jwmelvin/airRoaster/state-plan.md

# state-plan — planned work and phase specifications

> Companion to [state-current.md](state-current.md) (what is active now) and
> [state-archive.md](state-archive.md) (what is done, and the review findings
> these phases answer). Findings are referenced as F-numbers from the archive.

## NEXT — remaining on-roaster validation

The live sessions of 2026-07-02/03/04 (see the archive's v0.12–v0.15 entries)
validated much of the original checklist; items are marked accordingly.
Remaining drills, roughly in commissioning order:

1. ~~**Boot sync sanity**~~ — **done/superseded.** Heat-zero at boot stands;
   fan-level adoption via `getLevel()` was replaced by the RTC no-init shadow
   (v0.15.0, reads lie while firing). Fan-through-reboot validated 2026-07-04
   via a live OTA update with the fan running.
2. **Sensor path**: BT read sane in live sessions, but the specific checks are
   unrecorded — `STAT` after a few minutes (`loopMaxUs` should be dominated by
   the ~30 ms display push, not sensor reads); compare RTD fault frequency in
   the log against pre-v0.8.0 roasts (emi.md addendum says what to expect).
3. **Failsafe drills** (roaster cold, heat low): engage `INLET`, unplug the
   inlet TC → expect `inlet failsafe: inlet PV stale` within ~3 s, heat 0,
   mode manual. Confirm a TUNE aborts the same way.
4. **Telemetry + dashboard** — **mostly done**: the commissioning sequence
   (TUNE → APPLY → FF cal → INLET) ran end-to-end in the 2026-07-03 session.
   Still unchecked: kill/restore WiFi to see auto-reconnect on both sides.
5. **WDT confidence**: none of the normal paths (tune, big display repaints,
   WS bursts) should approach 8 s — `loopMaxUs` gives the margin number.
6. ~~**DimmerLink reset escalation**~~ — **superseded.** v0.13.0 removed
   autonomous resets entirely (soft reset drives the output full-on for
   ~3–4 s); resets are operator-only via `DLRESET`. The fw-version line at
   boot is still worth a glance.
7. **Interlock config (v0.10.0)**: from the dashboard panel set soft mode and
   custom limits, confirm the heat cap follows the fan slider accordingly, then
   power-cycle and confirm the values and mode survive (NVS). Try an invalid
   set (`IL 0 55 30`) and confirm it is rejected.
8. ~~**Power linearization (v0.11.0)**~~ — **done.** TUNE and FF calibration
   were re-run post-map; closed loop settles on SV and FF compensates fan
   steps (validated 2026-07-03, v0.14.1).
9. **OTA idle gate (v0.12.0)**: an OTA push with heat > 0 should time out on
   the host, then succeed again at heat 0. The happy path (idle OTA push,
   reboot, fan preserved) is validated.
10. **Curve experiments** (`CURVE FAN 0|2`, optional): compare fan response per
    level step on the dashboard chart; expectation is RMS (1) remains best.
    Reboot restores RMS automatically.
11. **Cooldown guard (v0.16.0)** — *mostly validated 2026-07-05*: deferral,
    hold, auto-release, and soak-back re-enforcement all observed working on
    the roaster. The 30 s dwell released early into soak-back (two re-enforce
    cycles), so the dwell is now adjustable (`COOL DWELL <s>`, NVS): find the
    dwell that makes one release stick (start ~90–120 s) and set it. Still
    unchecked: `COOL MIN`/`COOL DWELL` surviving a power cycle (NVS), and
    `COOL OFF` releasing a held fan immediately.
12. **Ambient reporting (v0.17.0)** — on a cold roaster, power up and check the
    serial log for `ambient: cold-start capture` with a sane room temp (BT vs
    CJ within 8 °C); dashboard Ambient panel should show it. Then run the
    roaster hot, power-cycle, and confirm the log says `warm boot … keeping`
    and the stored capture is unchanged. Check `AMB SRC`/`AMB <degC>` survive
    a power cycle (NVS). In Artisan: map the `AT` node to an extra WebSocket
    channel, select it on Config › Device › Ambient, and confirm Roast
    Properties picks up the ambient temperature at CHARGE (README § Ambient
    temperature has the click-path).
13. **Command auth (v0.18.0)** — with `AUTH_KEY` in secrets.h: dashboard
    authenticates automatically (key field) and `AUTH` reports authed; set
    `AUTH MODE CONFIG` and confirm an *unkeyed* browser gets "AUTH required"
    for `PID`/`IL`/`COOL MIN` but can still run `OT1 60`, `OT1 0`, `INLET
    OFF`, `COOL ON`; set `AUTH MODE FULL` and confirm `OT1 60` is refused
    unkeyed while `OT1 0` still works; run `tools/roaster_proxy.py` with the
    key and confirm live Artisan drives sliders through it in FULL mode;
    wrong-key proxy → refused; mode survives a power cycle (NVS); serial
    stays fully trusted. Also confirm a keyless build (empty AUTH_KEY)
    behaves exactly as v0.17.

## Completed phases (specs kept for reference; details in the archive)

## Phase 1 — firmware safety (FW 0.7.0) — DONE 2026-07-02

*Answers F1 (boot level mismatch), F3 (closed-loop sensor failsafe), F6
(unchecked dimmer writes), F8 (no watchdog).*

1. **Boot dimmer sync.** After `initDL()` for both modules: force heat to 0
   (`setLevel(HEAT_ADDR, 0)`, retried); read the fan's actual level with
   `getLevel(FAN_ADDR)` and adopt it into `fanLevel` — after a crash mid-roast
   the fan keeps cooling the hot roaster while the heat is killed. Log if the
   sync fails.
2. **Inlet-loop failsafe.** Track inlet-PV freshness (`inLastGoodMs` stamped in
   `updateSensors()` on every accepted MAX31855 read). In `MODE_INLET`:
   - PV stale (> `INLET_PV_STALE_MS`, 3000 ms) → drop to `MODE_MANUAL`,
     heat 0, `logError`, broadcast. A frozen hold-last-good PV must never keep
     feeding the integrator.
   - Over-temp (`inTemp > INLET_OVERTEMP_C`, reuse 280 °C) → same action.
   - `MODE_TUNE` gains the same stale-PV abort (it already has over-temp).
3. **Checked dimmer writes.** `applyInterlock()` and the OT2 path only update
   the cached level when `setLevel()` returns true; on failure the cache keeps
   the old value so the next loop retries, with a rate-limited log entry. Add a
   **readback audit** to the existing 5 s DimmerLink error poll: `getLevel()`
   both channels; mismatch against the cached value → log + rewrite.
4. **Task watchdog.** `esp_task_wdt` (IDF 5 API: `esp_task_wdt_reconfigure` /
   `_init` with `esp_task_wdt_config_t`, `trigger_panic = true`, ~8 s), add the
   loop task, `esp_task_wdt_reset()` each loop; feed it inside the WiFi connect
   wait until Phase 3 makes that non-blocking. Safe only because of item 1.

## Phase 2 — MAX31865 direct-register driver (FW 0.8.0) — DONE 2026-07-02

*Answers F2 (blocking one-shot reads / defeated continuous-mode design) and
F10 (blind jitter metric). Datasheet traceability in state-archive.md.*

1. New local header `max31865_direct.h`, small class, no external deps:
   - Own SPI transactions: `SPISettings(1_000_000, MSBFIRST, SPI_MODE1)`,
     manual CS. Registers: read `0x0N`, write `0x8N`, MSB first, auto-increment
     multibyte.
   - `begin()`: config = `VBIAS(0x80) | AUTO(0x40)` (+3-wire/50 Hz bits if ever
     needed; we run 4-wire, 60 Hz ⇒ 0xC0), thresholds armed (below), faults
     cleared. Filter bit set before enabling auto mode (datasheet forbids
     changing the notch while converting).
   - `reassert()`: rewrite the config byte — this makes the existing
     `RTD_REASSERT_MS` stall guard actually meaningful.
   - `readRaw(bool &fault)`: one 2-byte read at 0x01; bit 0 of the pair is the
     per-sample fault flag; value is the 15-bit ratio.
   - `readFault()` / `clearFault()`: plain register read of 07h (no
     master-initiated fault cycle — the Adafruit default knocks the chip out of
     auto mode); clear via config D1 with D5/D3/D2 zero.
   - Temperature from raw via Callendar–Van Dusen (same math as the Adafruit
     `calculateTemperature`, implemented locally).
   - Threshold arming: convert `RTD_VALID_MIN_C`/`RTD_VALID_MAX_C` to raw via
     forward CVD `R = R0(1 + AT + BT²)` (B-term adequacy at −20 °C is fine for
     a fault threshold), write as 15-bit << 1. The chip then latches D7/D6 on
     every out-of-window conversion — on-silicon EMI evidence.
2. Rework `serviceRtd()` to use the driver: the two-read disagree check
   becomes two cheap register reads (a true SPI-glitch detector), fault
   evidence is no longer destroyed by the read path, and per-sample fault bits
   feed the debounce. Median filter, debounce, hold-last-good, rate-limited
   logging all stay as-is.
3. Remove the `Adafruit_MAX31865` dependency (keep MAX31855 — verified
   non-blocking and correct).
4. **Honest load metric**: track worst single `loop()` duration (µs) alongside
   the control-jitter watch; report and reset both via `STAT`
   (`loopMaxUs` field). The old metric couldn't see in-pass blocking.

## Phase 3 — protocol hardening + telemetry (FW 0.9.0) — DONE 2026-07-02

*Answers F4 (garbage parses as zero), F5 (JSON envelope int-rounds the ramped
setpoint), F7 (WiFi), F9 (DimmerLink extras), tune-settled flag, and adds the
telemetry channel the dashboard needs.*

1. **Strict numeric parsing** (`parseFloatStrict`/`parseIntStrict`): `OT1 x`
   or `PID a b c` is rejected with a reply to the sender, never treated as 0,
   and never persisted to NVS.
2. **JSON envelope keeps floats**: `{"command":"INLET","value":183.4}` becomes
   `INLET 183.40` (currently rounded to int — quantizes Artisan's ramped
   playback to 1 °C steps).
3. **WiFi**: bounded connect wait (~15 s, WDT-fed, display progress), then boot
   proceeds regardless; `setAutoReconnect(true)` plus a rate-limited reconnect
   check in loop; display already shows state. Roaster must be fully usable
   over serial with no WiFi.
4. **TUNE result gains `"settled":true|false`** — a timeout fit underestimates
   dT and suggests too-hot gains; the flag says whether to trust it.
5. **DimmerLink extras**: log VERSION (reg 0x03) at init; escalate to COMMAND
   RESET (reg 0x01 ← 0x01) after N consecutive error-poll failures, then
   re-init (re-assert curve, restore level). Level readback audit came in
   Phase 1.
6. **`FF AMB` with no value** seeds `ffAmbient` from the MAX31855 cold-junction
   temperature (`readInternal()`), with the enclosure-warmer-than-room caveat
   documented.
7. **Telemetry push**: every `TELEM_PERIOD_MS` (default 1000 ms; 500 ms during
   TUNE) broadcast
   `{"pushMessage":"telem","data":{"t":<ms>,"IN":..,"BT":..,"ET":..,"sv":..,"heat":..,"heatReq":..,"fan":..,"ilCap":..,"mode":"..","p":..,"i":..,"d":..,"ff":..,"fltIN":0|1,"fltBT":0|1}}`
   — the PID terms come from the last `controlStep()`. `TELEM <ms>|OFF` command
   (clamped 100–10000). Skip building the string when no client is connected.

## Phase 4 — dashboard rebuild — DONE 2026-07-02

Single file, zero dependencies, works from `file://`. Grouped panels:

1. **Connection** — IP (remembered), connect/disconnect, auto-reconnect with
   backoff, status dot.
2. **Status** — mode badge (manual/inlet/tune), heat bar showing applied vs
   requested, fan bar, interlock state/cap, inlet SV.
3. **Temperatures** — large IN/BT/ET readouts, per-channel fault badges from
   telemetry flags.
4. **Inlet tuning** (the centerpiece) —
   - Canvas strip chart: IN (PV) and SV on the temperature axis, heat on a
     0–100 % axis; rolling buffer (≥30 min at 1 Hz), pause, window selector,
     CSV export of the buffer.
   - PID editor prefilled from `pid` pushes; FF editor (`ffK`, ambient, CAL,
     OFF); live P/I/D/FF term readout.
   - TUNE workflow: start (step % field), abort; on result show the model
     (Kp/tau/theta/dT, settled flag) and both gain sets with **Apply tight**
     and **Apply cons** buttons (cons applies via `PID <kp> <ki> 0`).
5. **Console + log** — every message timestamped into a capped capture buffer;
   per-class filter checkboxes (status/telem/error/log/tune-pid-ff-stat/sent/
   other; telem hidden by default), free-text filter, **Save log** (.txt
   download) — the device log is 8 RAM entries, so the browser is the real
   archive; `LOG` requested on connect.
6. **Commissioning** — existing sequence panel, retained and updated.

## Phase 5 — docs sync — DONE 2026-07-02

- README: interlock constants (code says 48/55/30, README says 23/30/30),
  dashboard path (repo root, not `artisan/`), delete the stale "BT/ET stubbed
  at 0.0" paragraph, document new commands (`TELEM`, no-arg `FF AMB`), boot
  dimmer sync, watchdog, WiFi behavior, `settled` flag, direct-driver sensor
  path.
- emi.md addendum: the library one-shot discovery — unbiased auto-convert
  windows between polls were a plausible contributor to spurious `0x60`
  faults; continuous mode changes the experiment. Note what to watch in the
  next roast's fault log.
- Keep state docs current per the update discipline in state-current.md.

## Later / not scheduled

- **Evaluate moving the DimmerLink link from I2C back to UART serial.** The
  modules ship UART-by-default and were switched to I2C during provisioning
  (see [config.md](config.md) § 3); on this project's questionable wiring the
  serial link has looked *at least as noise-tolerant* as I2C. Worth a
  controlled comparison — if serial holds up, it may be the more robust
  transport here. Would touch the DimmerLink transport layer in
  `airRoaster.ino` (register reads/writes, `initDL`/`assertDLState`,
  boot sync) but not the control law; keep the commit-on-ack + re-assert
  robustness shape (v0.13). Cross-reference the EMI history in
  [hardware/emi.md](hardware/emi.md).
- **Auto-provision a fresh DimmerLink module in place (UART→I2C on the I2C
  pins).** A factory module ships on UART at the default I2C address `0x50`
  ([config.md](config.md) § 3); today that switch is a separate bench sketch.
  Idea: do it in-firmware without rewiring by temporarily driving the I2C pins
  (SDA `GPIO3` / SCL `GPIO4`) as a UART through the ESP32-S3 GPIO matrix. Flow:
  on boot (or a `DLPROVISION HEAT|FAN` command), if the expected address does
  not ACK, tear down `Wire`, bring a UART peripheral up on those pins, send
  `SWITCH_I2C` (`0x5B`), wait for the mode to persist, tear the UART down,
  `Wire.begin()`, write the target address to reg `0x30`, verify `VERSION`.
  Open questions to resolve first: (a) confirm the module's UART TX/RX land on
  the *same* two physical pins as its I2C SDA/SCL (the "two-bus" connector) —
  this is the crux; (b) confirm the DimmerLink UART baud/framing from the UART
  protocol docs; (c) collision — two fresh modules both answer `0x50`, so this
  only works with a single unaddressed module on the bus (provision one at a
  time, or before the second is wired); (d) safety — only with heat off and the
  boot heat-zero intact. Payoff: plug in a replacement dimmer and it
  self-provisions.
- **Data-driven device registry (add a device via a `.json` change) — all
  buses.** Make adding an *auxiliary* peripheral a config edit, not a code
  edit: a small JSON manifest of `{bus, addressing, type, role, options}` the
  firmware reads at boot to instantiate/parse the device. The idea is not
  I2C-specific — it applies the same way across **all three buses**, with the
  bus deciding the addressing field: I2C → device address, SPI → chip-select
  pin (+ SPI mode/clock), serial/UART → port + baud/framing. Candidate
  storage: a compiled-in JSON string, an NVS blob, or a LittleFS/SPIFFS file
  flashed with the firmware (or pushed from the dashboard). Scope guard: keep
  the **safety-critical core** devices (both dimmers, inlet TC, the RTDs)
  hardcoded and interlocked — the registry is for optional sensors first (the
  BME688 ambient below, an extra RTD, environmental sensors) whose presence and
  wiring vary. A full driver-plugin system is a large refactor; a lighter first
  cut is a table of *known* optional device types keyed by bus+address. Ties
  into the dimmer auto-provision above (address assignment) and the BME688 item
  below.
- **Cryptographic authentication of the command interface (safety/security).**
  **→ PROMOTED 2026-07-10: in development as v0.18.0 on `feature/auth-proxy`**
  (see state-current.md). The notes below are the original design record.
  Today the WebSocket server on `:81` accepts plaintext commands from anyone on
  the network — `OT1`/`OT2`/`INLET`, and the safety config (`IL`, `COOL`,
  `DLRESET`, `PID`, `FF`, `CURVE`, `AMB`). On a private WLAN the risk is low,
  but this drives a **heating element**, so an unauthenticated write path is the
  standing exposure. Goal: only authorized clients can issue state-changing
  commands. **The hard constraint is Artisan**: its WebSocket client speaks
  plain `ws://` with no auth header, token, or `wss` client-cert support, so
  mandatory auth would break the primary use. Design has to be layered:
  - Keep the *read* path (`getData`, telemetry, `LOG`, `STAT`) and the Artisan
    *slider* commands usable, and authenticate the privileged/mutating commands
    — or gate privileged commands to the dashboard only while Artisan keeps a
    reduced, network-trust-scoped surface.
  - Candidate mechanisms, lightest first: **HMAC-signed command envelope**
    (shared key + monotonic nonce/timestamp for replay protection) — cheap, no
    TLS handshake, fits the existing JSON envelope; **challenge–response
    session auth** on connect (device issues a nonce, client proves the shared
    key, session trusted thereafter); or full **`wss`/TLS** via mbedTLS (heavier
    on RAM/latency, and still doesn't solve Artisan). OTA already carries a
    shared password (`OTA_PASS`) — precedent for a secret in `secrets.h` + NVS.
  - Dashboard gotcha to verify early: the browser HMAC needs Web Crypto
    (`crypto.subtle`), which requires a **secure context** — `file://` and
    `localhost` qualify, but a dashboard served over `http://<lan-ip>` may not,
    which would block signing. Confirm before committing to a browser-HMAC
    design.
  - **Parked (2026-07-10, operator decision):** mandatory auth stays off the
    table for now because Artisan must keep sending commands or the setup
    doesn't work. The workable shape, if/when revisited, is a **localhost
    signing proxy**: Artisan connects to `ws://127.0.0.1:<port>` on the
    operator's machine (unauthenticated but localhost-bound), and the proxy
    holds the shared key and signs traffic to the roaster, which rejects
    unsigned writes. Artisan needs no changes beyond the Host field. The
    "laptop becomes the sole operator" concern is softer than it sounds:
    *keyed devices* are operators (any machine with the key can run the proxy;
    the dashboard could HMAC directly), and the Artisan machine is already the
    operator console — the proxy co-locates with it. What's lost is ad-hoc
    access from unkeyed devices; the fix is an unauthenticated **safe subset**
    in firmware — reads plus safety-increasing commands only (`OT1 0`,
    `INLET OFF`, `COOL ON`) — so anything on the network can still stop the
    roaster, never start it. **Operator-approved (2026-07-10): the safe subset
    is a requirement of any future auth design**, not an optional mitigation.
    A proxy crash mid-roast is no worse than
    Artisan crashing: the firmware failsafes are client-independent.
  - Open questions: which exact commands are "privileged" vs open; replay/nonce
    persistence across reboot; key provisioning + rotation; and whether to pair
    this with network-level isolation (roaster VLAN) as the pragmatic near-term
    mitigation while the crypto path is built.
- **OTA hardening beyond the dedicated password** (first-order fix shipped
  2026-07-11: `auth_key.py ota` generates a random `OTA_PASS`, closing the
  WIFI_PASS fallback where anyone on the WLAN could push firmware). Two
  further layers, deliberately deferred: (a) **OTA arming** — only call
  `ArduinoOTA.handle()` for ~5 min after an authenticated `OTA ARM` command
  (TIER_CONF or serial), so a push needs both secrets and accidental pushes
  are impossible; cheap (a flag + timeout + one command) and consistent with
  the existing idle gate — do this one first if OTA exposure ever worries us
  again. (b) **Signed images / ESP32 Secure Boot** — defends adversaries who
  already hold the passwords; Secure Boot burns irreversible eFuses and the
  ESP32 Arduino core lacks built-in update signing (unlike ESP8266), so this
  is real toolchain work for a threat beyond the stated LAN model. espota
  transport remains cleartext either way — key-bearing flashes stay on USB.
- ET RTD probe installation → set `RTD_ET_ENABLED 1` (sensor code is ready).
- BME688 ambient sensor on STEMMA QT (`0x76/0x77`) — would give a true room
  ambient for feedforward instead of the cold-junction estimate.
- DimmerLink curve-mode experiments: curve is set to RMS (mode 1) at
  startup; LINEAR/LOG untested.
- Move `controlStep()` to a pinned FreeRTOS task if `STAT` evidence (post
  Phase 2, when the metric is honest) ever shows the cooperative loop failing
  its cadence.
- String→char parsing in hot paths if heap fragmentation ever shows (low
  priority on the S3 with PSRAM).
