jwmelvin/airRoaster/artisan/artisan_help_events.md

# Artisan Event Configuration Help

Copied from Artisan's help dialogs for the Event configuration (Buttons and Sliders tabs), reformatted for readability.

## Event Custom Buttons

Button numbers can be drag-and-dropped to a new position. While holding ALT (Windows) / OPTION (macOS), buttons are swapped instead.

### Button table columns

| Column | Description |
|---|---|
| Button Label | Enter `\n` to create labels with multiple lines. `\t` is substituted by the event type. |
| Event Description | Description of the event to be recorded. |
| Event Type | Event type to be recorded, or leave blank for no event. `±` types add a chosen offset (positive or negative) to the present value of the chosen event. |
| Event Value | Value of the event (1–100) to be recorded. |
| Action | Perform an action at the time of the event. |
| Documentation | The action command. Depends on the action type; `{}` is replaced by the event value (plus the offset for `±` event types). |
| Button Visibility | Hides/shows the individual button. |

### Configuration options

| Option | Description |
|---|---|
| Max buttons per row | Sets a maximum number of buttons to display on a single row. |
| Button size | Sets a size for the buttons: tiny, small, or large. |
| Color Pattern | Applies one of 99 autogenerated color patterns to the buttons. Set to `0` to choose button colors manually. |
| Mark Last Pressed | Inverts state and color of the last button pressed. |
| Tooltips | Shows the button specification as a tooltip when hovering over a button. |
| Add | Adds a new button to the bottom of the table. |
| Insert | Inserts a new button above the selected button. |
| Delete | Deletes the selected button. |
| Copy Table | Copies the button table in tab-separated format to the clipboard. Option/ALT-click to copy a tabular format instead. |
| Help | Opens this window. |

### Label substitutions

The following substitutions are applied to button labels:

| String | Substitution |
|---|---|
| `\n` | New line character |
| `\t` | Event name (translated if using default event names) |
| `\q` | Event type 1 |
| `\w` | Event type 2 |
| `\e` | Event type 3 |
| `\r` | Event type 4 |
| `\0` | OFF (translated) |
| `\1` | ON (translated) |
| `\2` | OFF (translated, respecting button state) |
| `\3` | ON (translated, respecting button state) |
| `\p` | STOP (translated) |
| `\s` | START (translated) |
| `\P` | STOP (translated, respecting button state) |
| `\S` | START (translated, respecting button state) |
| `\c` | CLOSE (translated) |
| `\o` | OPEN (translated) |
| `\C` | CLOSE (translated, respecting button state) |
| `\O` | OPEN (translated, respecting button state) |
| `\a` | AUTO (translated) |
| `\m` | MANUAL (translated) |
| `\A` | AUTO (translated, respecting button state) |
| `\M` | MANUAL (translated, respecting button state) |
| `\i` | STIRRER |
| `\f` | FILL |
| `\D` | DISCHARGE |
| `\R` | RELEASE |
| `\h` | HEATING |
| `\l` | COOLING |
| `\b` | FLAP |
| `\d` | CONTROL |
| `\V` | Event value |
| `\F` | Event value interpreted as temperature in Fahrenheit, converted to the current temperature mode |
| `\T` | Event value interpreted as temperature in Celsius, converted to the current temperature mode |

### Button commands

Notes:

- `{}` can be used as a placeholder; it is substituted by the current button value plus the offset for `±` event types. If the placeholder occurs several times in a description/command, all occurrences are replaced by the value.
- The placeholders `{ET}`, `{BT}`, `{time}`, `{ETB}`, `{BTB}`, and `{WEIGHTin}` are substituted by the current ET, BT, time, ET background, BT background value, and batch size (in g) in Serial/Artisan/CallProgram/MODBUS/S7/WebSocket commands.
- Commands can be sequenced, separated by semicolons: `<cmd1>;<cmd2>;<cmd3>`.
- All characters given as documentation to a **Serial Command** action are sent as one string to the connected device. If the device can interpret this string as separate commands separated by semicolons, this is fine. Otherwise, use a **Multiple Event** referencing several event buttons (via a comma-separated list of event button numbers as the documentation string), where each referenced button issues one command via its own Serial Command action. Those buttons can be hidden, giving the same effect as if the Serial Command allowed a sequence of commands.
- In PHIDGET commands, the optional parameter `<sn>` has the form `<hub_serial>[:<hub_port>]` and refers to a specific Phidget HUB by its serial number, optionally specifying the port the addressed module is connected to.

#### Simple actions

| Action | Command | Description |
|---|---|---|
| Serial Command | ASCII serial command or binary `a2b_uu(serial command)` | |
| Call Program | A program/script path (absolute or relative) | Starts an external program |
| Multiple Event | Button numbers or `sleep(<float>)` separated by commas: `1,2,sleep(2.5),3` | Triggers other buttons |
| p-i-d | `<p>;<i>;<d>` | Configures PID to the values `<p>;<i>;<d>` |
| Fuji Command | `write(<unitId>,<register>,<value>)` | |

#### Artisan Command

| Command | Description |
|---|---|
| `$` | Variable holding the last state of the button pressed (1 or 0) |
| `alarm(n,<bool>)` | Enables/disables alarm number `n` |
| `alarms(<bool>)` | Enables/disables alarms |
| `autoCHARGE(<bool>)` | Enables/disables autoCHARGE |
| `autoDROP(<bool>)` | Enables/disables autoDROP |
| `sleep(<float>)` | Adds a delay of `<float>` seconds |
| `tare(<int>)` | Tares channel `<int>` with 1: ET, 2: BT, 3: E1c1, 4: E1c2, … |
| `PIDon` | Turns PID on |
| `PIDoff` | Turns PID off |
| `PIDtoggle` | Toggles the PID state |
| `pidmode(<int>)` | Sets PID mode to 0: manual, 1: RS, 2: background follow |
| `p-i-d(<p>,<i>,<d>)` | Sets the p-i-d parameters of the PID |
| `pidWeights(<beta>,<gamma>)` | Sets the beta and gamma parameters of the PID |
| `adjustSV(<float>)` | Increases or decreases the current target SV value by `<float>` |
| `pidSV(<float>)` | Sets the PID target set value SV |
| `pidSVC(<float>)` | Sets the PID target set value SV, given in °C |
| `pidRS(<rs>)` | Activates the PID Ramp-Soak pattern number `<rs>` (1-based!) or the one labeled `<rs>` |
| `pidSource(<int>)` | Selects the PID input source: 0: BT, 1: ET (Software PID); 0–3 (Arduino PID) |
| `pidLookahead(<int>)` | Sets the PID lookahead in seconds |
| `replayLookahead(<int>)` | Sets the Ramping Event Replay lookahead in seconds |
| `popup(<msg>[,<int>])` | Shows a popup with message `<msg>`, optionally auto-closing after `<int>` seconds |
| `message(<msg>)` | Shows message `<msg>` in the message line |
| `notifications(<bool>)` | Enables/disables notifications; while disabled, issued notifications are ignored |
| `notify(<title>[,<msg>])` | Sends a notification with title `<title>` and optional message `<msg>` |
| `setCanvasColor(<color>)` | Sets canvas color to the RGB-hex `<color>`, e.g. `#27f1d3` |
| `resetCanvasColor` | Resets canvas color |
| `button(i,b)` | Sets button `i` to pressed if `b` is yes/true/t/1, otherwise to normal |
| `button(<name>\|<bool>)` | Activates button `<name>` from { START, CHARGE, DRY, FCs, FCe, SCs, SCe, DROP, COOL, OFF }; sets the calling button to "pressed" if the argument is 1 or True |
| `button()` | Toggles the state of the button |
| `visible(i,b)` | Sets button `i` to visible if `b` is yes/true/t/1, otherwise to hidden |
| `palette(<p>)` | Activates palette `<p>`, either a number 0–9 or a palette label |
| `playbackmode(<int>)` | Sets playback mode to 0: off, 1: time, 2: BT, 3: ET, 4: BT/time, 5: ET/time |
| `playbackdropmode(<int>)` | Sets playback DROP mode to 0: off, 1: time, 2: BT, 3: ET |
| `playback(n,<bool>)` | Toggles playback per event type `n` from {1,2,3,4} |
| `ramp(n,<bool>)` | Toggles playback ramping per event type `n` from {1,2,3,4} |
| `slider(n,<bool>)` | Shows/hides the slider per event type `n` from {1,2,3,4}; `n=5` toggles the PID SV slider visibility |
| `quantifier(n,<bool>)` | Activates/deactivates quantification per event type `n` from {1,2,3,4} |
| `setBatchSize(<float>)` | Sets the batch size to the given value. If the value is negative, the batch size is taken from the background profile, if one is loaded |
| `openProperties` | Opens the Roast Properties dialog |
| `loadBackground(<filepath>)` | Loads the `.alog` profile at the given filepath as background profile |
| `clearBackground` | Clears the current background profile |
| `alarmset(<as>)` | Activates the alarmset with the given number or label |
| `moveBackground(<direction>,<int>)` | Moves the background profile the indicated number of steps in `<direction>`: up, down, left, or right |
| `keyboard(<bool>)` | Enables/disables keyboard mode |
| `keepON(<bool>)` | Enables/disables the Keep ON flag |
| `showCurve(<name>,<bool>)` | Shows/hides the curve indicated by `<name>`, one of { ET, BT, DeltaET, DeltaBT, BackgroundET, BackgroundBT } |
| `showExtraCurve(<extra_device>,<curve>,<bool>)` | Shows/hides the `<curve>` (one of {T1, T2}) of the zero-based `<extra_device>` number |
| `showEvents(<event_type>,<bool>)` | Shows/hides the events of `<event_type>` in [1..5] |
| `showBackgroundEvents(<bool>)` | Shows/hides the events of the background profile |

#### WebSocket Command

| Command | Description |
|---|---|
| `$` | Variable holding the last state of the button pressed (1 or 0) |
| `send(<json>)` | If `{}` substitutions are used, JSON brackets need to be duplicated to escape them, as in `send({{ "value": {}}})` |
| `sleep(<float>)` | Adds a delay of `<float>` seconds |
| `button(i,b)` | Sets button `i` to pressed if `b` is yes/true/t/1, otherwise to normal |
| `button(<bool>)` | Sets the calling button to "pressed" if the argument evaluates to 1 or True |
| `button()` | Toggles the state of the button |
| `read(<json>)` | If the `<json>` text respects the JSON format, it is sent to the connected WebSocket server and the response is bound to the variable `_` |

## Event Custom Sliders

### Slider table columns

| Column | Description |
|---|---|
| Event | Hide or show the corresponding slider. |
| Action | Perform an action on slider release. |
| Command | Command to perform, depends on the Action type. `{}` is replaced by (slider value × Factor + Offset). |
| Offset | Offset added to the slider value (after scaling by Factor). |
| Factor | Scale factor; the slider value is multiplied by this value. |
| Min | Sets the minimum value of the slider range. |
| Max | Sets the maximum value of the slider range. |
| Course | When ticked, the slider moves in steps of 10. |
| Temp | Should be ticked when the slider's value is a temperature, so Artisan can properly scale the value between Celsius and Fahrenheit. |
| Unit | Optional text used in annotations for the units of the slider value. |

### Slider commands

Notes:

- `{}` can be used as a placeholder; it is substituted by (value × factor + offset). In all slider command actions except IO, VOUT, S7, and RC Commands, the bound value is converted from float to int.
- The placeholders `{ET}`, `{BT}`, `{time}`, `{ETB}`, `{BTB}`, and `{WEIGHTin}` are substituted by the current ET, BT, time, ET background, BT background value, and batch size (in g) in Serial/Artisan/CallProgram/MODBUS/S7/WebSocket commands.
- Commands can be sequenced, separated by semicolons: `<cmd1>;<cmd2>;<cmd3>`.
- In PHIDGET commands, the optional parameter `<sn>` has the form `<hub_serial>[:<hub_port>]` and refers to a specific Phidget HUB by its serial number, optionally specifying the port the addressed module is connected to.
- In YOCTOPUCE commands, the optional parameter `<sn>` holds either the module's serial number or its name.

#### Simple actions

| Action | Command | Description |
|---|---|---|
| Serial Command | ASCII serial command or binary `a2b_uu(serial command)` | |
| Call Program | A program/script path (absolute or relative) | Starts an external program |
| Fuji Command | `write(<unitId>,<register>,<value>)` or `sleep(<float>)` | |

#### Artisan Command

Sliders support the same Artisan commands as buttons (see [Artisan Command](#artisan-command) above), with these differences:

- No `$` variable.
- No `alarms(<bool>)`, `button(i,b)`, `button()`, or `visible(i,b)`.
- `button(<name>)` takes only a name from { START, CHARGE, DRY, FCs, FCe, SCs, SCe, DROP, COOL, OFF } — no `<bool>` form.

#### WebSocket Command

| Command | Description |
|---|---|
| `send(<json>)` | If `{}` substitutions are used, JSON brackets need to be duplicated to escape them, as in `send({{ "value": {}}})` |
| `sleep(<float>)` | Adds a delay of `<float>` seconds |
| `button(<bool>)` | Sets the calling button to "pressed" if the argument evaluates to 1 or True |
| `read(<json>)` | If the `<json>` text respects the JSON format, it is sent to the connected WebSocket server and the response is bound to the variable `_` |
