jwmelvin/airRoaster/(commit log)

2026-06-07 Send error log to Serial when LOG command received over serial
    [airRoaster_v01.ino]
2026-06-08 Add Artisan WebSocket protocol support
    Handle Artisan's getData request/response cycle with matching id field.
    Stub BT/ET temperature floats ready for real sensor integration.
    Plain-text OT1/OT2 commands remain for direct and slider control.
2026-06-08 Wrap all push messages in Artisan pushMessage envelope
    Status, error, and log broadcasts now use {"pushMessage":"<type>","data":...}
    for a consistent format across Artisan and other WebSocket clients.
    [airRoaster_v01.ino]
2026-06-08 Document sensor expansion path in README
    Explains how to add channels to the main WebSocket device and how
    to configure extra Artisan devices for additional sensors.
2026-06-08 Fix sensor expansion docs: clarify 10-channel limit and extra device path
    All extra devices point at the same WebSocket endpoint; a second port
    is only needed beyond 10 total channels.
2026-06-22 Add soft interlock mode, IL toggle command, and Artisan config context
    Replaces the single FAN_INTERLOCK_THRESHOLD with a two-mode interlock:
    hard (binary cutoff at IL_FAN_MIN) and soft (linear ramp from IL_FAN_MIN
    to IL_FAN_FULL). The IL command toggles between modes. Status broadcast
    now reports ilCap and ilSoft instead of the old interlock bool.
    DimmerLink init moved before WiFi to avoid missing the ready window.
    Adds artisan_config_context.md documenting the full Artisan setup.
    [airRoaster_v01.ino]
2026-06-28 Add sensor reading, Artisan IN channel, and display temp readout
    Initializes MAX31865 (BT, ET) and MAX31855 (IN) sensors with continuous
    conversion; polls every 250 ms. Adds IN to the Artisan getData response
    and displays all three temps on the bottom OLED row.
2026-06-29 Add closed-loop inlet temperature control (v0.3.0)
    Internalize inlet-temp regulation so heat is modulated on-device instead of
    via Artisan's 1 Hz command cycle. New switchable MODE_INLET runs a PI(D) loop
    in controlStep(), with manual OT1 control as an instant override.
    Control law:
    - Derivative-on-measurement (no setpoint kick), low-pass filtered; starts
    PI-only (Kd=0) since the inlet TC is noisy near the dimmers.
    - Back-calculation anti-windup against the *applied* (post-interlock) heat, so
    the fan interlock capping heat can't wind up the integrator.
    - Bumpless engage; repeated INLET calls retarget without resetting the
    integrator (gradual setpoint changes during a roast don't reset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
    [airRoaster_v01.ino]
2026-06-29 Add feedforward airflow compensation (v0.5.0)
    Robustness against airflow changes — the primary design driver. Adds a
    physics-form feedforward summed into the control output:
    heat_ff = ffK * fan * (SV - ambient)
    Steady-state heater power scales with airflow times temperature rise, so a fan
    change moves heat immediately in proportion and the PID only trims the residual,
    instead of waiting for the inlet temperature to drift and the integrator to
    catch up. One coefficient covers the narrow fan band.
    - FF command: report / set ffK / FF AMB <degC> / FF CAL / FF OFF.
    - FF CAL auto-calibrates ffK = heat / (fan * (inlet - ambient)) from the current
    steady operating point.
    - Off by default (f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
    [airRoaster_v01.ino]
2026-06-30 Persist tuning set in NVS; fix OLED temp refresh (v0.6.0)
    Persistence: store PID gains (kp/ki/kd) and feedforward params (ffK,
    ffAmbient) in NVS flash via the Preferences library, namespace "tuning".
    loadTuning() at boot restores stored values over the compile-time
    placeholders (a virgin device keeps the defaults); saveTuning() is called
    only from the PID, TUNE APPLY, and FF mutation paths — never the control
    loop — so flash wear is negligible.
    Display: the OLED only repainted on command/tune events, so the temperature
    readout went stale between commands. Add a 1 Hz repaint heartbeat decoupled
    from the 250 ms sensor poll, keeping the full-framebuffer I2C push (a ~30 ms
    cooperative-loop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
    [airRoaster.ino]
2026-06-30 Add Artisan settings for firmware-side inlet control
    airRoaster_inlet.aset is a variant of airRoaster.aset configured for the
    internalized control loop (firmware MODE_INLET): Artisan sends the inlet
    setpoint rather than running its own PID. Adds a 0-300 °C "Inlet" SV slider
    and Inlet OFF / 190 / 220 buttons that emit INLET commands over WebSocket
    (send({"command":"INLET","value":...})). Fan/heat sliders unchanged; the
    original profile is left intact.
2026-07-02 Add ramped-playback events mode to inlet background generator
    make_inlet_background.py --events N emits N discrete T_inlet (event
    type 3) special events sampled off the shaped curve. Artisan's
    background-event playback (replay "by time") linearly interpolates the
    slider between them and fires send({"command":"INLET","value":{}}) each
    tick, streaming interpolated INLET setpoints to the firmware's
    closed-loop control.
    Points are progressively concentrated over the final portion of the
    roast (--tail-width / --tail-bias) for finest setpoint resolution
    through the development phase and the drop. Event value encoding, type,
    annotation strings, and charge alignment verified against Artisan
    source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
2026-07-02 README: link DimmerLink I2C protocol doc in the hardware table
    Add the dimmerlink-I2CCommunication reference next to the DimmerLink
    overview link, alongside the I2C addresses and curve-mode details it
    documents.
2026-07-02 Add state documents: current effort, phase plan, review-findings archive
    Development framework for picking up the project fresh: build workflow,
    ground-truth docs, conventions, safety posture, and the July 2026 review
    findings (F1-F12) with datasheet verification that grounds phases 1-5.
2026-07-02 Phase 1 safety: boot dimmer sync, inlet failsafe, commit-on-ack writes, WDT (v0.7.0)
    - Boot: heat forced to 0, fan's actual level adopted via getLevel, so an
    MCU-only reset can't leave the heater running against zeroed state (F1)
    - MODE_INLET drops to manual at heat 0 on stale PV (>3s) or over-temp
    (280C); TUNE gains the stale-PV abort (F3)
    - Dimmer level caches update only on acked I2C writes, failures retry
    every loop with rate-limited logging; 5s readback audit re-asserts
    level+curve on drift (F6)
    - esp_task_wdt (8s, panic->reset) on the loop task, fed during the WiFi
    connect wait (F8)
    [airRoaster.ino]
2026-07-02 Phase 2: direct-register MAX31865 driver, true continuous mode (v0.8.0)
    Replaces the Adafruit MAX31865 read path (F2): its temperature() is a
    blocking one-shot (~75ms delay per read) that toggles VBIAS off and
    clears the fault register on entry — stalling the loop ~150ms per 250ms
    cycle and defeating serviceRtd()'s continuous-mode design. New
    max31865_direct.h (register access per hardware/max31865.pdf pp.13-18):
    - chip held in auto-convert (VBIAS|AUTO, 60Hz notch); reads are
    microsecond register accesses
    - atomic RTD MSB+LSB read; per-sample fault bit feeds the robust layer
    - on-chip fault thresholds armed to the plausibility window
    - config re-assert makes the RTD_REASSERT stall guard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
    [airRoaster.ino, max31865_direct.h]
2026-07-02 Phase 3: strict parsing, float envelope, WiFi resilience, DL recovery, telemetry (v0.9.0)
    - Strict numeric parsing with error replies: garbage no longer coerces
    to 0 (OT1/OT2/INLET/PID/TUNE/FF); a typo can't persist zero gains (F4)
    - JSON command envelope preserves the fractional value so Artisan's
    ramped INLET playback isn't quantized to 1C steps (F5)
    - WiFi: bounded 15s connect, boots without network, loop-side link
    watch with reconnect kick (F7)
    - TUNE results carry "settled" — timeout fits suggest too-hot gains
    - DimmerLink: fw version logged at init, per-address rate-limited error
    logging, persistent-error streak escalates to module soft reset with
    curve/level re-assert (F9)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
    [airRoaster.ino]
2026-07-02 Phase 4: dashboard rebuild — grouped panels, tuning chart, durable log capture
    Single-file, zero-dependency rewrite around the v0.9.0 telemetry feed:
    - Connection: remembered IP, auto-reconnect with backoff, safety
    shortcuts (HEAT 0 / INLET OFF / TUNE ABORT) always visible
    - Status: mode badge, applied-vs-requested heat bar, fan bar, interlock
    - Temperatures: IN/BT/ET readouts with per-channel fault badges and a
    telemetry-freshness indicator
    - Inlet control: canvas strip chart (IN/SV/BT on temp axis, heat/fan on
    % axis, 5-60 min windows, pause, CSV export), PID/FF editors prefilled
    from device reports, step-test workflow with settled warning and
    one-click apply of tight or conse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
2026-07-02 Phase 5: docs sync — README current, emi.md addendum, state docs closed out
    - README: interlock constants match code (48/55), startup sequence
    documents boot dimmer sync/WDT/bounded WiFi, stale BT/ET stub note
    replaced, TELEM + no-arg FF AMB + settled flag + failsafe documented,
    telem push schema added, error-logging section reflects rate limiting
    and reset escalation, dashboard path fixed (repo root), MAX31855 added
    to dependencies with a note on why MAX31865 is driven register-direct
    - emi.md: addendum on the library one-shot discovery — unbiased
    auto-convert windows as a plausible self-inflicted 0x60 contributor —
    and what to watch in the next roast's fault log
    - state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
2026-07-02 Add MAX31855/MAX31865 datasheets referenced by the direct driver and state docs
2026-07-02 Runtime-configurable interlock, NVS-persisted, dashboard panel (v0.10.0)
    Interlock limits (fanMin/fanFull/heatAtMin) and hard/soft mode are now
    runtime state, stored in NVS namespace "interlock" like the tunings;
    compile-time constants remain as first-boot defaults. Validated on set
    and on load (1 <= fanMin <= fanFull <= 100, heatAtMin <= 100) — bad NVS
    data falls back to defaults with a logged error, and fanMin >= 1 so the
    heater can never be configured to run with the fan off. loadInterlock()
    runs before the boot dimmer sync so the first applyInterlock() uses the
    operator's limits.
    BREAKING: bare IL now reports (new "il" push with soft/fanMin/fanFull/
    heatAtMin/cap) instead of toggling;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
    [airRoaster.ino]
2026-07-02 Dashboard layout: Setpoint+Manual row first, then PID/FF/Step test, then Interlock; fan quick buttons
    Manual group gains one-tap fan levels (0/50/55/60) and OT2 UP/DOWN
    nudge buttons.
2026-07-02 Dashboard: fan controls inline right of heat; fan −/+ nudges by 1
    The −/+ buttons send an absolute OT2 level computed from the last
    status/telem-reported fan value (firmware UP/DOWN steps by 5), clamped
    0–100, with a clear error if no fan level has been reported yet.
2026-07-02 DUTY_STEP 5 -> 1: single-percent UP/DOWN nudges (v0.10.1)
    The fan operates over a narrow, sensitive band, so 5%-steps overshoot.
    Dashboard fan -/+ buttons now use the device-atomic OT2 DOWN/UP instead
    of the absolute-set workaround (removed).
    [airRoaster.ino]
2026-07-02 Heat power linearization + runtime CURVE command (v0.11.0)
    Heat % now means % of max heater power: on the RMS curve the dimmer
    level is linear in Vrms so power went as level²; commanded heat passes
    through a sqrt map at the hardware write boundary (heatDimmerLevel).
    All firmware state — PID, FF, interlock, tune, telemetry, display —
    stays in command/power units; only setLevel writes and the readback
    audit/reset paths translate. Plant gain is now constant across the
    range and the feedforward's heat∝power assumption holds. RE-TUNE
    REQUIRED: pre-v0.11.0 gains/ffK are in raw dimmer units.
    New CURVE command (report / CURVE HEAT|FAN 0..2): runtime-only by
    design — power-on default return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
    [airRoaster.ino]
2026-07-02 Document heat-command quantization under the power map
    Above ~25% power the sqrt map's slope is below 1, so adjacent heat
    commands can collapse to the same dimmer level (~2:1 near full scale).
    This is the hardware's true power resolution (101 Vrms steps, P∝V²)
    made visible, not a loss from the map; immaterial in INLET mode where
    the integrator dithers between adjacent levels.
2026-07-02 Chart: time axis autoscales to collected data
    Temperature already autoscaled (min/max of visible series + padding);
    the time axis was a fixed rolling window, leaving a young session
    huddled at the right edge. The x-span now starts at the first sample
    (capped by the window selector, floored at 60s) and tick spacing
    follows the displayed span, with seconds shown on sub-minute ticks.
2026-07-03 OTA firmware updates over WiFi (v0.12.0)
    ArduinoOTA (espota, no new external deps), serviced from loop() only
    while the roaster is idle (manual mode, heat commanded and confirmed 0)
    so a flash write can never stall the interlock/failsafes with the heater
    energized. onStart re-zeros the heater at the wire and detaches the task
    WDT for the write; a failed update re-arms it and logs. verify.sh pins
    the TinyUF2 OTA partition scheme (2x1408K app slots; NVS layout
    unchanged, tunings survive) and gains "./verify.sh ota [host]". First
    flash after the scheme change must be over USB.
    [airRoaster.ino]
2026-07-03 DimmerLink: remove auto-reset escalation, write-based convergence (v0.13.0)
    First on-roaster run of the v0.7 dimmer robustness code exposed two
    hardware facts (fan module, level 50): register reads lie while the
    module is firing (level reads back 0, error register returns garbage),
    and a soft reset drives the output FULL ON for ~3-4 s. The escalation
    was therefore soft-resetting a healthy module every 15 s and surging
    the fan to 100%; on the heat channel this would have been uncommanded
    full heater power, possibly with no airflow.
    Reads are now diagnostics only ("not responding" distinguished from
    error codes, rate-limited); convergence comes from unconditionally
    re-asserting curve+level ev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
    [airRoaster.ino]
2026-07-03 Negative integral trim under FF + dashboard FF step calibration (v0.14.0)
    First closed-loop test held a +10 C offset at SV 150: a stale NVS ffK
    made FF=80 where the plant needed ~50, and the integrator's [0,100]
    floor could not go negative to cancel it, leaving the P term to carry
    the excess via standing error. The integral is now bounded so the
    steady command I+FF stays within 0..100 (I in [-ff, 100-ff]) --
    identical to the old bounds when FF is off.
    Companion dashboard-only routine (FF step cal panel): in closed loop at
    a steady setpoint, measure baseline heat, step the fan, wait for
    re-settle, restore the fan, and compute ffK as the slope
    dHeat/(dFan*(SV-amb)) with one-click apply. Slope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
    [airRoaster.ino]
2026-07-03 Inlet over-temp failsafe 280 -> 350 C (v0.14.1)
    The setpoint clamp already allowed INLET 300 but the failsafe tripped
    at 280, killing the loop mid-seek. 350 leaves overshoot margin over the
    SV max. Tune abort stays at 280.
    [airRoaster.ino]
2026-07-03 Fan level survives MCU-only resets via RTC no-init RAM (v0.15.0)
    Boot fan adoption read getLevel(), which lies while the module is
    firing: after any reboot with the fan running, adoption read 0 and the
    5 s re-assert physically stopped the fan (observed post-OTA), breaking
    the mid-roast crash-recovery airflow guarantee. The commanded fan level
    is now shadowed in RTC_NOINIT_ATTR RAM (magic + inverted-copy checksum,
    zero flash wear): valid across crash/WDT/panic/OTA reboots, restored
    and asserted at boot; garbage after a true power-on, falling back to 0
    to match the also-unpowered fan module. The fan now keeps spinning
    seamlessly across OTA updates with the UI in sync.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
    [airRoaster.ino]
2026-07-04 README: add temperature-measurement modules to the hardware table
2026-07-04 Dashboard: load a saved CSV export back into the chart
    Load CSV button parses an exported file (columns matched by header
    name) into the chart buffer, auto-pausing so live telemetry doesn't
    mix in. The time axis anchors to the loaded data's own range, and a
    new "all" window option shows a whole roast at once. View controls
    (window/BT/pause) now redraw immediately instead of waiting for the
    next telemetry tick.
2026-07-04 Log tooling: downsample_logs.py condenses roast logs for review
    Auto-detects Artisan .alog profiles, dashboard CSV exports, and dashboard
    saved text logs. Keeps sparse data exact (events, timeindex marks, mode/fan/
    SV/fault transitions, non-telemetry log lines), reduces the dense series to
    time-bucket means with a rate-of-rise column, and computes closed-loop
    tracking stats (IN vs SV error mean/rms/max, heat saturation, per-plateau
    breakdown). SV <= 0 is treated as "no setpoint" to match firmware v0.15.1.
    Stdlib only.
    [downsample_logs.py]
2026-07-04 INLET 0 means no setpoint: drop to manual, heat 0 (v0.15.1)
    A follow-background test ended with Artisan's SV slider at 0; the firmware
    clamped it to INLET_SV_MIN_C (0 C) and kept the loop engaged on an
    unreachable target -- P railed at about -280 with heat pinned at 0 for the
    whole cooldown (2026-07-04 dashboard log). INLET <sv <= 0> now disengages to
    manual with heat 0 (the operator's cooldown intent); INLET OFF is unchanged
    (disengage, hold heat). README command table/control section and
    state-current updated. Compile-verified; on-roaster check: SV slider to 0 ->
    mode manual, heat 0.
2026-07-05 Cooldown guard: fan shutdown deferred until inlet stays cool (v0.16.0)
    The fan may stop only once the inlet has stayed below 70 C for the
    release dwell on fresh readings with heat off. A fan command below the
    cooldown minimum while hot is deferred (held at coolFanMin, requested
    level auto-applies when criteria are met); a hot roaster with the fan
    below minimum gets airflow forced back on autonomously. Stale-hot
    sensor keeps the fan running; COOL OFF is the runtime-only escape.
    COOL MIN (default 50) and COOL DWELL (default 30 s, made adjustable
    after the 2026-07-05 drill saw two soak-back re-enforce cycles) persist
    in NVS namespace "cool". New COOL command, "cool" push, status "cool"
    field,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
2026-07-06 verify.sh: print FW_VERSION before compiling
2026-07-08 Ambient reporting: AT channel for Artisan, cold-junction surfaced (v0.17.0)
    getData gains an "AT" node (degC) for Artisan's ambient-temperature source
    (Config > Device > Ambient tab, sampled at CHARGE). Three sources via the
    new AMB command (NVS "amb"): cold-start memory (BT RTD captured once per
    boot, only when it matches the MAX31855 cold junction within 8 C — a hot
    power cycle keeps the last cold capture), live cold junction, or manual.
    Cold junction now read every sensor poll and pushed in telemetry (cj/amb);
    dashboard gets a CJ readout and an Ambient panel (manual entry in F or C,
    converted to C on send). README + state docs updated.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
2026-07-09 README: add a Further documentation reference table
    Links the companion docs (hardware pin map, EMI/sensor-noise history,
    triac protection, the register-direct RTD driver, Artisan config context,
    and the state/work development docs) with a one-line description of each.
2026-07-09 state-current: main now holds v0.17.0 (feature/ambient merged)
2026-07-10 docs: add config.md (secrets, DimmerLink UART→I2C, Artisan setup)
    New config.md collects the out-of-band setup steps: secrets.h credentials,
    the DimmerLink factory UART→I2C dimmer provisioning (SWITCH_I2C 0x5B, then
    address 0x30 → heat 0x51 / fan 0x52; redo for replacement modules), and the
    full Artisan WebSocket configuration (Config > Port > WebSocket Nodes row:
    BT/ET/IN/AT on Inputs 1–4, plus sliders and the Ambient-tab step).
    README: correct the Artisan section to lead with Config > Port > WebSocket,
    add Input 4 → AT, and link config.md in the Further-documentation table.
    state-plan.md: note the possible move from I2C back to UART serial for the
    dimmer link (looks at least as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
2026-07-10 Refresh Artisan .aset (BT/ET/IN/AT); plan dimmer auto-provision + I2C registry
    artisan/airRoaster.aset: refreshed from the working Artisan config —
    WebSocket channel_nodes now BT, ET, IN, AT (Inputs 1–4).
    state-plan.md § Later: two new ideas —
    - auto-provision a fresh DimmerLink module in place by temporarily driving
    the I2C pins (SDA/SCL) as UART to send SWITCH_I2C, then re-addressing over
    I2C (open questions: shared UART/I2C pinout, baud, 0x50 collision, safety);
    - a data-driven (.json) registry for adding auxiliary I2C devices, with the
    safety-critical core devices kept hardcoded.
2026-07-10 plan: generalize device registry to all buses; add command-auth item
    state-plan.md § Later:
    - device registry idea applies across all three buses, not just I2C — bus
    decides the addressing field (I2C address / SPI chip-select / UART port+baud).
    - new cryptographic-authentication item for the command interface: threat is
    the unauthenticated heater-control write path; the hard constraint is that
    Artisan speaks plain ws:// with no auth, so any scheme must be layered
    (keep read + slider path, authenticate privileged commands). Candidate
    mechanisms (HMAC envelope / challenge-response / wss), the browser
    secure-context gotcha for Web Crypto, and open questions captured.
    Co-Authored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
2026-07-10 plan: park command auth; record the localhost-proxy design and rationale
    Operator decision 2026-07-10: mandatory auth is parked — Artisan must keep
    sending commands. If revisited, the shape is a localhost signing proxy on
    the operator's machine (Artisan -> ws://127.0.0.1, proxy holds the key and
    signs to the roaster), with an unauthenticated safety-increasing command
    subset (OT1 0, INLET OFF, COOL ON) left open in firmware so any device can
    stop the roaster but not start it. Notes on why "sole operator" is really
    "keyed devices", and that a proxy crash is no worse than an Artisan crash.
2026-07-10 Command authentication: challenge-response sessions + Artisan proxy (v0.18.0)
    WebSocket clients prove a shared AUTH_KEY (secrets.h; absent = feature off,
    device unchanged from v0.17) via connect-time challenge-response: device
    pushes a random nonce, client answers AUTH HMAC-SHA256(key, nonce-hex), and
    the connection is trusted until it drops (per-failure re-nonce, 5 fails burn
    the connection). Tiered enforcement AUTH MODE OFF|CONFIG|FULL (NVS):
    CONFIG gates safety/config mutations while OT1/OT2/INLET stay open for
    direct Artisan; FULL gates every mutation. Always-open safe subset in every
    mode (operator requirement): reads plus OT1 0, INLET OFF/0, COOL ON,
    TUNE ABORT - any device can stop th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
    [airRoaster.ino]
2026-07-11 Key management: tools/auth_key.py; proxy reads secrets.h automatically
    auth_key.py (stdlib-only): `generate` writes a 32-byte CSPRNG key (64 hex)
    into secrets.h — creating the file with placeholder WiFi credentials if
    absent, and refusing to replace an existing key without --rotate, since a
    key change locks out every client until updated. `show` prints the key for
    the dashboard paste; `hmac <nonce>` computes a challenge response for
    manual testing. secrets.h is the single source of truth: roaster_proxy.py
    now parses AUTH_KEY from it by default (--key / --key-file /
    AIRROASTER_KEY override, most-explicit-first) so the normal proxy
    invocation needs zero key configuration.
    Rotation flow docu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
2026-07-11 OTA hardening: auth_key.py ota generates a dedicated random OTA_PASS
    Without a dedicated OTA_PASS the firmware falls back to WIFI_PASS — a
    credential everyone on the WLAN knows by definition, meaning anyone on the
    network could push firmware. New `ota [--rotate]` subcommand writes a
    64-hex CSPRNG password into secrets.h at column 0, where verify.sh's sed
    already picks it up; the first flash after a change must go over USB (the
    device still expects the old password). Tested on a scratch secrets.h:
    append/refuse/rotate verified, the commented template line is never
    matched, and the proxy's read_auth_key import is unaffected.
    Docs: README OTA section + config.md; OTA arming and signed images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
2026-07-11 docs: replace artisan_help_sliders.md with combined artisan_help_events.md
    Covers both Event configuration tabs (buttons and sliders) from
    Artisan's help dialogs, reformatted into markdown tables.
2026-07-11 docs: fold Phidget fallback into config.md, drop artisan_config_context.md
    The old file was mostly superseded by README/config.md and partly wrong
    (BT/ET no longer stubbed; interlock thresholds now runtime-set). Its
    unique content — HUB5000 network details, TMP1200/TMP1101 inventory, and
    the Y3 symbolic-remap Artisan recipe — moves to config.md § 4.6 as a
    fallback/cross-check setup. Also fix the README doc-index row still
    pointing at the removed artisan_help_sliders.md.
2026-07-13 dashboard: auth badge beside the connection status
    The session's auth state at a glance, next to the connected indicator:
    "authed · <mode>" (green), "not authed · <mode>" (red), "challenged…",
    "auth off (no key on device)", and — the case that motivated this — a
    2.5 s probe that shows "auth: no reply — fw < 0.18?" when the device never
    answers AUTH at all (older firmware drops unknown keywords silently, which
    previously looked like "connected, nothing wrong"). Resets on disconnect.
    Verified in the browser: all badge states exercised via simulated pushes;
    challenge answer still matches the HMAC reference vector.
